attilabody/powerstrip/case/Powerstrip.FCStd

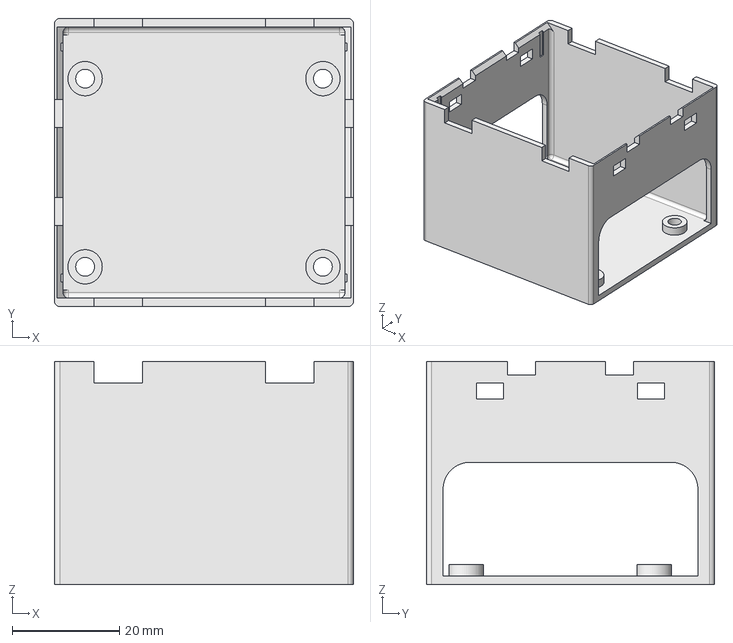
[picture p1: CAD file, 2021-05-16]
case/Powerstrip.FCStd
55.7 x 53.7 x 41.6 mm
