attilabody/powerstrip/electronics/MCU/MCU.kicad_pcb

## KiCad design electronics/MCU/MCU.kicad_pcb (2021-06-06)

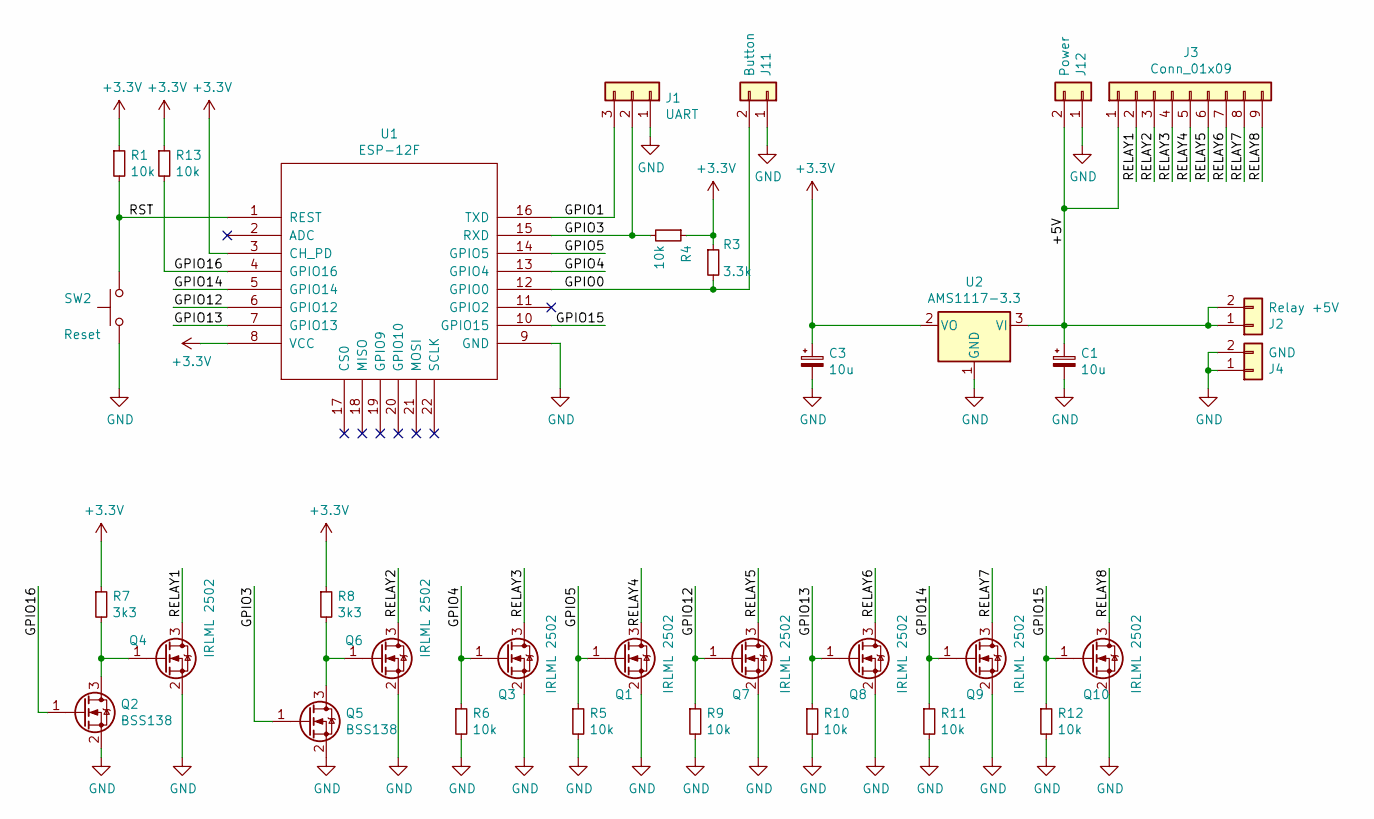
[picture p2: schematic MCU.sch]

Parts:
C1, C3: 10u; C_1206_3216Metric_Pad1.42x1.75mm_HandSolder
J1: UART; PinHeader_1x03_P2.54mm_Vertical
J2: Relay +5V; PinHeader_1x02_P2.54mm_Vertical
J3: Conn_01x09; PinHeader_1x09_P2.54mm_Vertical
J4: GND; PinHeader_1x02_P2.54mm_Vertical
J11: Button; JST_EH_B2B-EH-A_1x02_P2.50mm_Vertical
J12: Power; JST_EH_B2B-EH-A_1x02_P2.50mm_Vertical
Q1, Q3, Q4, Q6, Q7, Q8, Q9, Q10: IRLML 2502; SOT-23_Handsoldering
Q2, Q5: BSS138; SOT-23_Handsoldering
R1, R4, R5, R6, R9, R10, R11, R12, R13: 10k; R_0603_1608Metric_Pad1.05x0.95mm_HandSolder
R3: 3.3k; R_0603_1608Metric_Pad1.05x0.95mm_HandSolder
R7, R8: 3k3; R_0603_1608Metric_Pad1.05x0.95mm_HandSolder
SW2: Reset; SW_SPST_SKQG_WithStem
U1: ESP-12F; ESP-12E_SMD
U2: AMS1117-3.3; SOT-223-3_TabPin2

Connections:
+3V3: C3.1, R1.1, R3.1, R4.1, R7.1, R8.1, R13.1, U1.3 (CH_PD), U1.8 (VCC), U2.2 (VO)
/+5V: C1.1, J2.1, J2.2, J3.1, J12.2, U2.3 (VI); also elsewhere on the board
/GPIO0: J11.2, R3.2, U1.12 (GPIO0)
/GPIO1: J1.3, U1.16 (TXD)
/GPIO3: J1.2, Q5.1 (G), R4.2, U1.15 (RXD)
/GPIO4: Q3.1 (G), R6.1, U1.13 (GPIO4)
/GPIO5: Q1.1 (G), R5.1, U1.14 (GPIO5)
/GPIO12: Q7.1 (G), R9.1, U1.6 (GPIO12)
/GPIO13: Q8.1 (G), R10.1, U1.7 (GPIO13)
/GPIO14: Q9.1 (G), R11.1, U1.5 (GPIO14)
/GPIO15: Q10.1 (G), R12.1, U1.10 (GPIO15)
/GPIO16: Q2.1 (G), R13.2, U1.4 (GPIO16)
/RELAY1: J3.2, Q4.3 (D)
/RELAY2: J3.3, Q6.3 (D)
/RELAY3: J3.4, Q3.3 (D)
/RELAY4: J3.5, Q1.3 (D)
/RELAY5: J3.6, Q7.3 (D)
/RELAY6: J3.7, Q8.3 (D)
/RELAY7: J3.8, Q9.3 (D)
/RELAY8: J3.9, Q10.3 (D)
/RST: R1.2, SW2.1, U1.1 (REST)
GND: C1.2, C3.2, J1.1, J4.1, J4.2, J11.1, J12.1, Q1.2 (S), Q2.2 (S), Q3.2 (S), Q4.2 (S), Q5.2 (S), Q6.2 (S), Q7.2 (S), Q8.2 (S), Q9.2 (S), Q10.2 (S), R5.2, R6.2, R9.2, R10.2, R11.2, R12.2, SW2.2, U1.9 (GND), U2.1 (GND); also elsewhere on the board
unnamed: Q2.3 (D), Q4.1 (G), R7.2
unnamed: Q5.3 (D), Q6.1 (G), R8.2

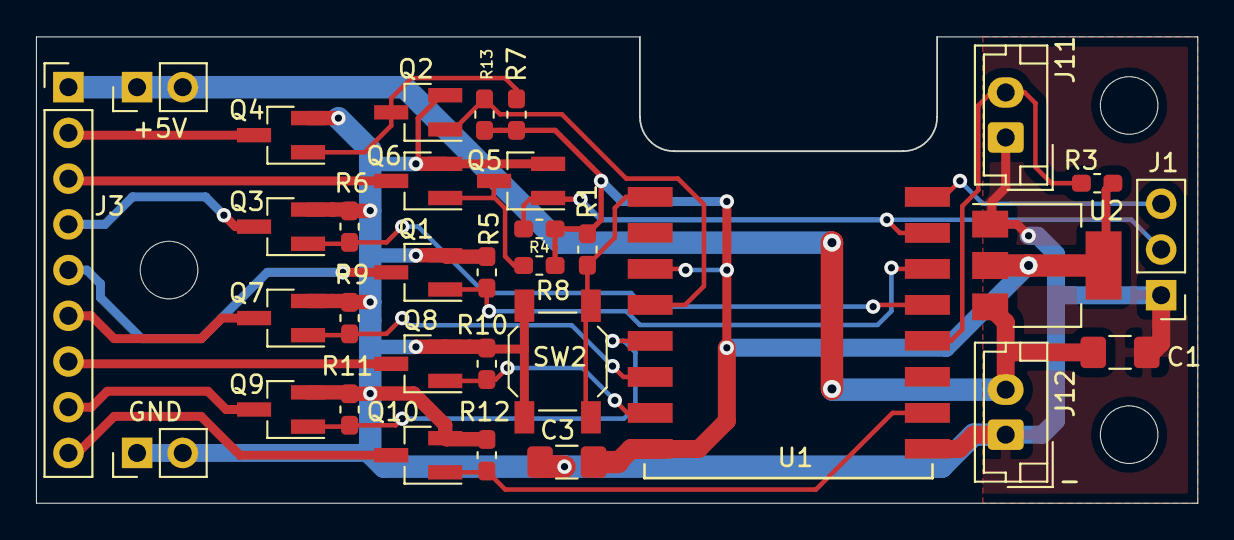
[picture p3: board MCU.kicad_pcb from above]

Board: 2 copper layers, 64.5 x 25.9 mm, 33 parts (0 on the bottom side), 24 nets.

Other parts of the board:
+5V: Relay +5V; PinHeader_1x02_P2.54mm_Vertical
GND: GND; PinHeader_1x02_P2.54mm_Vertical

Their connections:
/+5V: +5V.1, +5V.2; also elsewhere on the board
GND: GND.1, GND.2; also elsewhere on the board
