attilabody/powerstrip/electronics/relay/relay.kicad_pcb

## KiCad design electronics/relay/relay.kicad_pcb (2021-05-16)

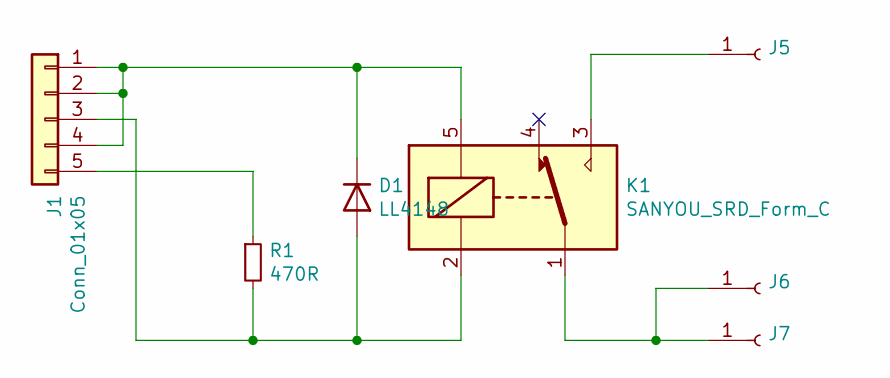
[picture p4: schematic relay.sch]

Parts:
D1: LL4148; D_MiniMELF
J1: Conn_01x05; PinHeader_1x05_P2.54mm_Vertical
J5, J6, J7: Conn_01x01_Female; SolderWire-Mains
K1: SANYOU_SRD_Form_C; Relay_SPDT_SANYOU_SRD_Series_Form_C
R1: 470R; R_0603_1608Metric_Pad0.98x0.95mm_HandSolder

Connections:
unnamed: D1.1 (K), J1.1, J1.2, J1.4, K1.5
unnamed: D1.2 (A), J1.3, K1.2, R1.2
unnamed: J1.5, R1.1
unnamed: J5.1, K1.3
unnamed: J6.1, J7.1, K1.1

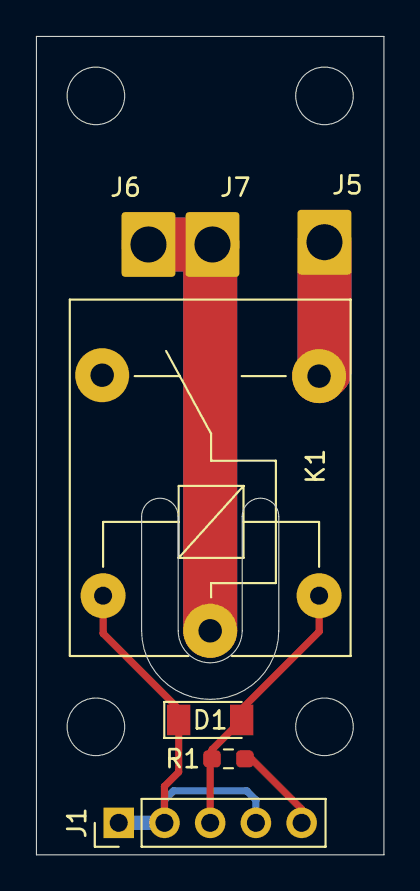
[picture p5: board relay.kicad_pcb from above]

Board: 2 copper layers, 19.3 x 45.5 mm, 7 parts (0 on the bottom side), 5 nets.
