attilabody/powerstrip/(commit log)

2021-04-12 Relay unit 1st iteration
    [powerstrip.kicad_pcb, powerstrip.sch]
2021-04-12 kicad project renamed
    [MCU.kicad_pcb, MCU.sch, relay.kicad_pcb, relay.sch]
2021-04-12 git subrepo clone (merge) https://github.com/jdunmire/kicad-ESP8266.git electronics/kicad-ESP8266
    subrepo:
    subdir: "electronics/kicad-ESP8266"
    merged: "1f3d2c6"
    upstream:
    origin: "https://github.com/jdunmire/kicad-ESP8266.git"
    branch: "master"
    commit: "1f3d2c6"
    git-subrepo:
    version: "0.4.3"
    origin: "https://github.com/ingydotnet/git-subrepo"
    commit: "87ee373"
2021-04-14 ESP8266 board design ready
    [MCU.kicad_pcb, MCU.sch]
2021-04-18 Relay board ready, ESP3266 redesign (GPIO16 instead of GPIO0)
    [MCU.kicad_pcb, MCU.sch, relay.kicad_pcb, relay.sch]
2021-04-19 MCU: GPIO3 instead if GPIO2
    [MCU.kicad_pcb, MCU.sch]
2021-04-19 Small PCB modifications, esphome config added
    [MCU.kicad_pcb, MCU.sch, relay.kicad_pcb, relay.sch]
2021-04-20 MCU: removed pullup from CH_PD (direct 3.3V) improved clearance around the antenna added FreeCad design for case (uncompressed)
    [MCU.kicad_pcb, MCU.sch, Powerstrip.FCStd]
2021-05-16 PCB 1st batch
    [MCU.kicad_pcb, relay.kicad_pcb]
2021-05-16 Socket case for another socket type
    [Powerstrip.FCStd]
2021-05-19 Housing: different caddys for the two supported socket versions
2021-05-19 PCB: parts moved a bit away from the JST connectors
    [MCU.kicad_pcb]
2021-05-29 LED hole moved
2021-05-30 PCB rotated by 180 degrees
2021-06-01 Rotated PCB was not a good idea after all Added hager holes on the back
2021-06-06 Housing: Electronics segment
    [MCU.kicad_pcb]
